pdjr-beatrice/beatrice-hood/kicad/beatrice-hood.dxf

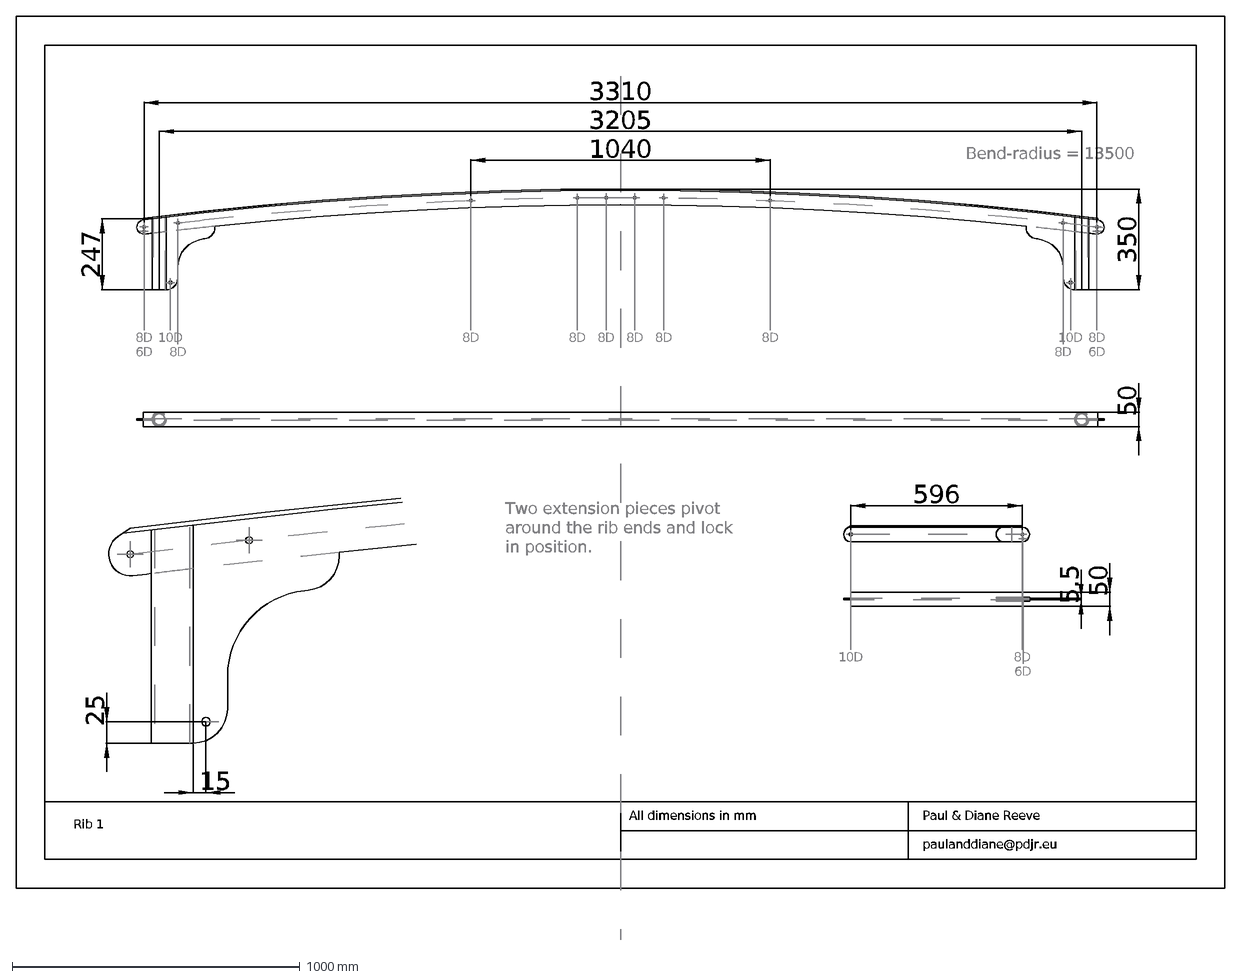
[picture p1: CAD file, 2021-06-12]
kicad/beatrice-hood.dxf
All dimensions in mm
Paul & Diane Reeve
paulanddiane@pdjr.eu
Bend-radius = 13500
25
15
8D
10D
247
6D
1040
3205
3310
350
50
596
Two extension pieces pivot around the rib ends and lock in position.
5.5
Rib 1
