pdjr-beatrice/beatrice-hood/pub/rib-1.pdf

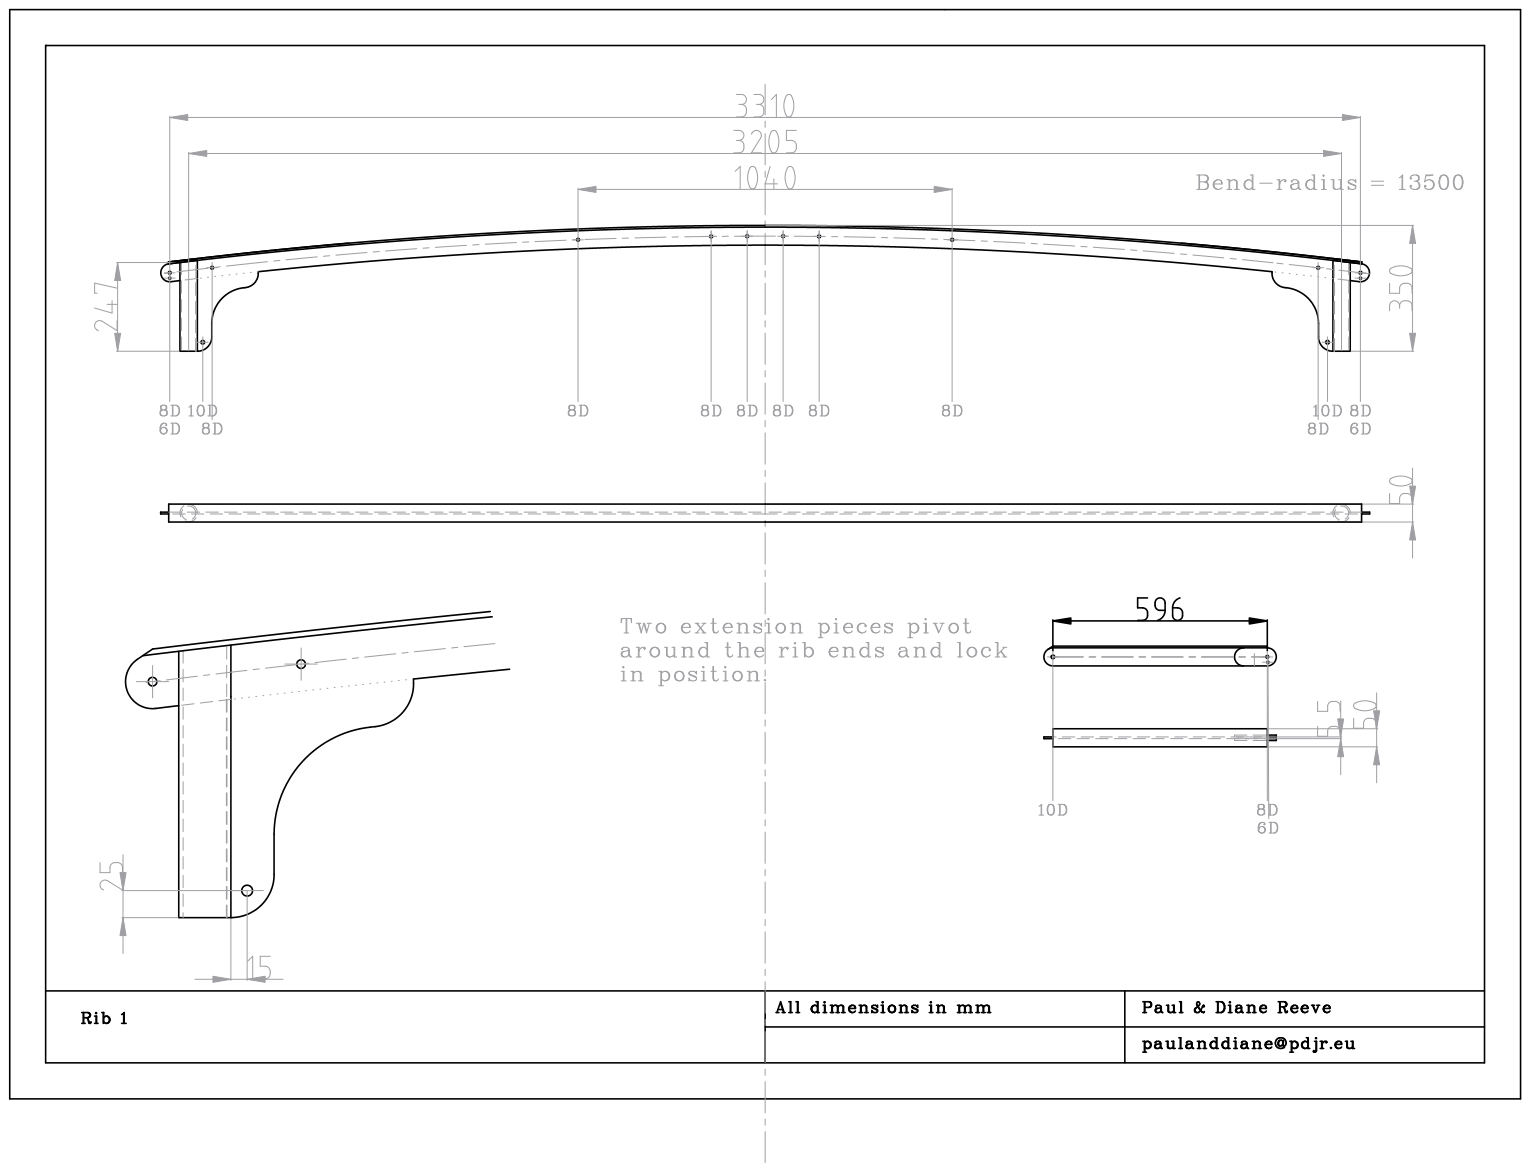
[picture p2: page 1]
