pdjr-beatrice/beatrice-hood/pub/plan.pdf

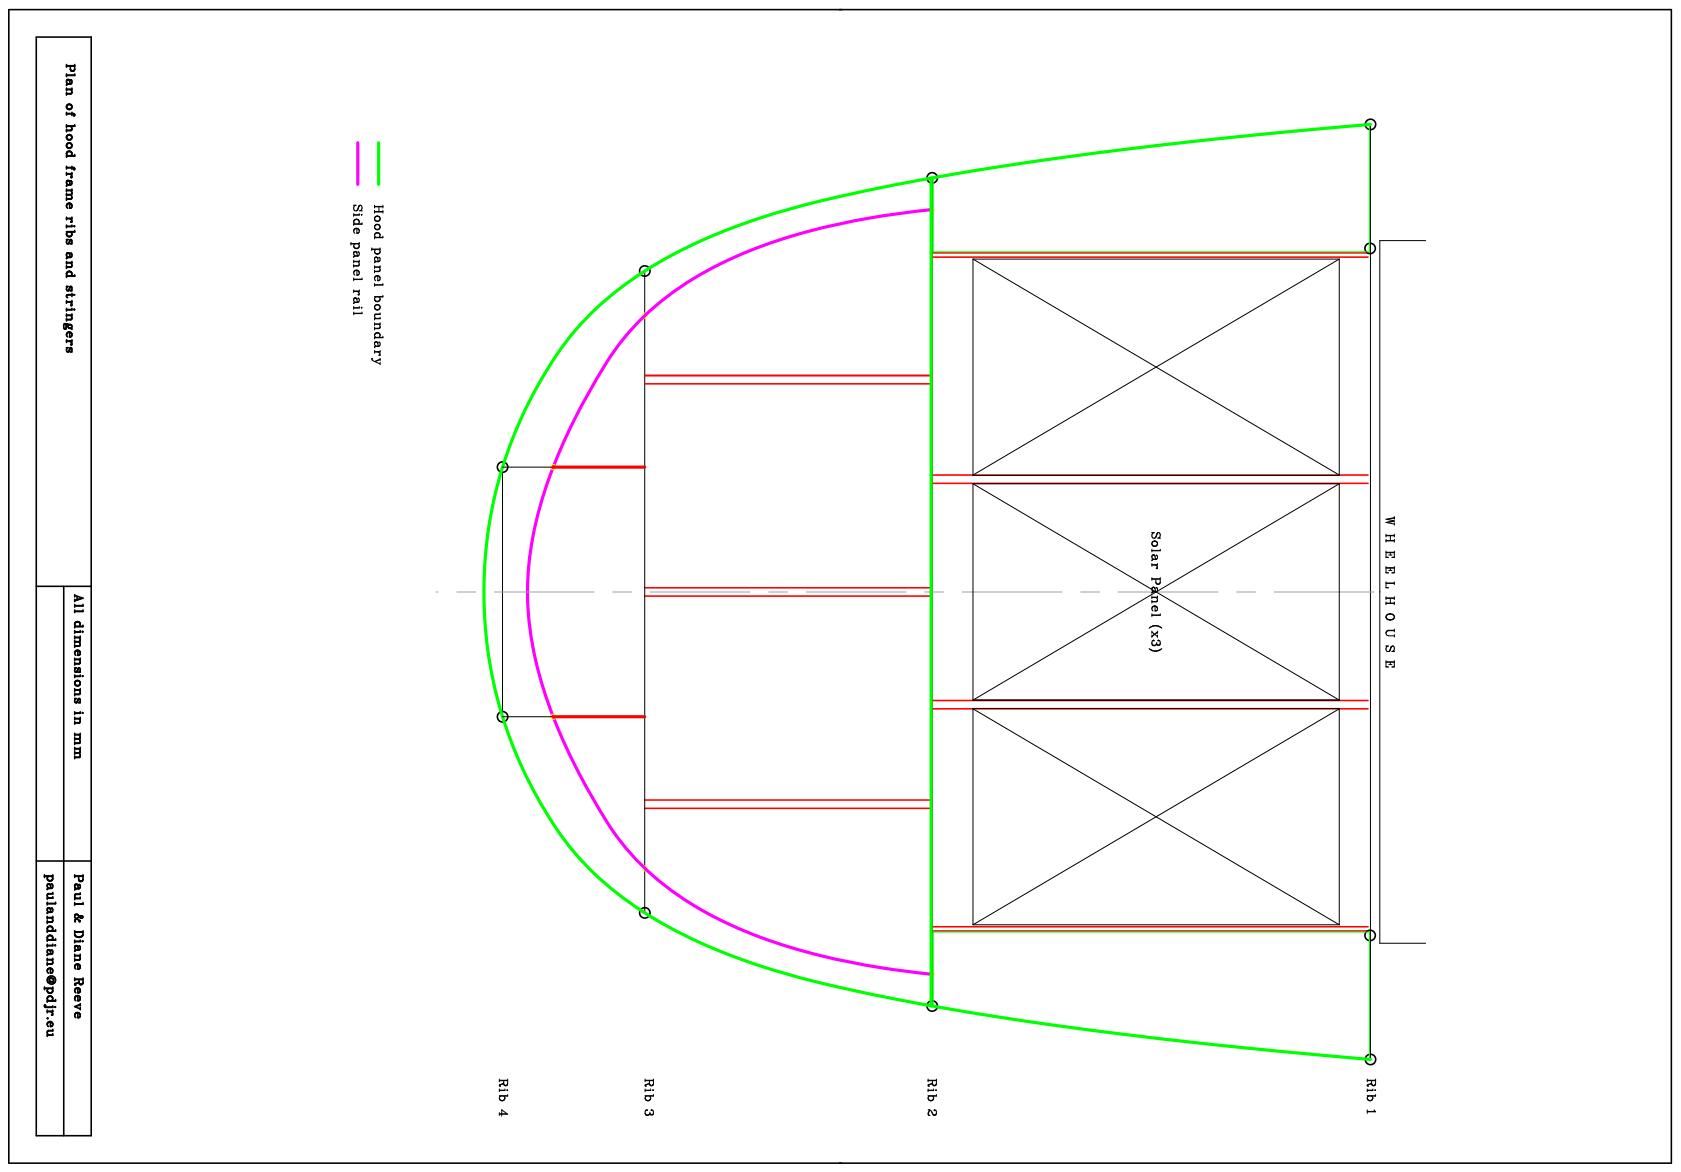
[picture p3: page 1]
