pdjr-beatrice/beatrice-hood/pub/rib-2.pdf

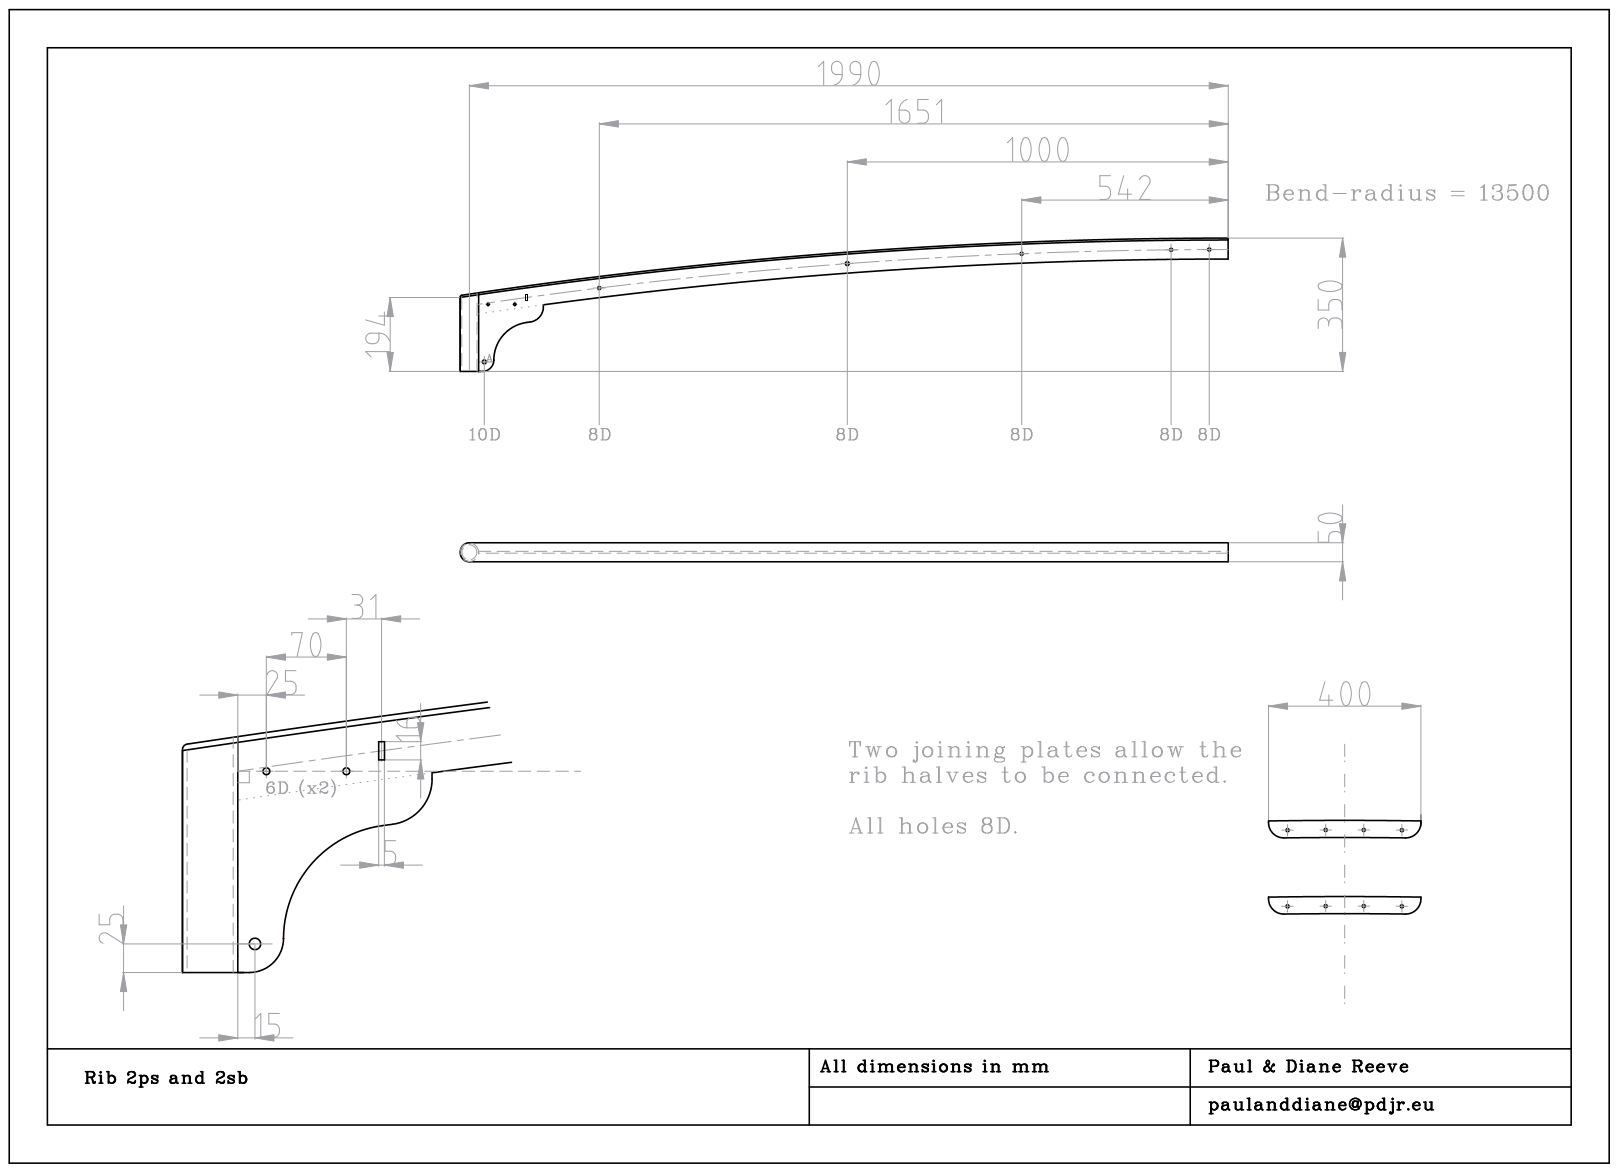
[picture p4: page 1]
