pdjr-beatrice/beatrice-hood/pub/rib-3.pdf

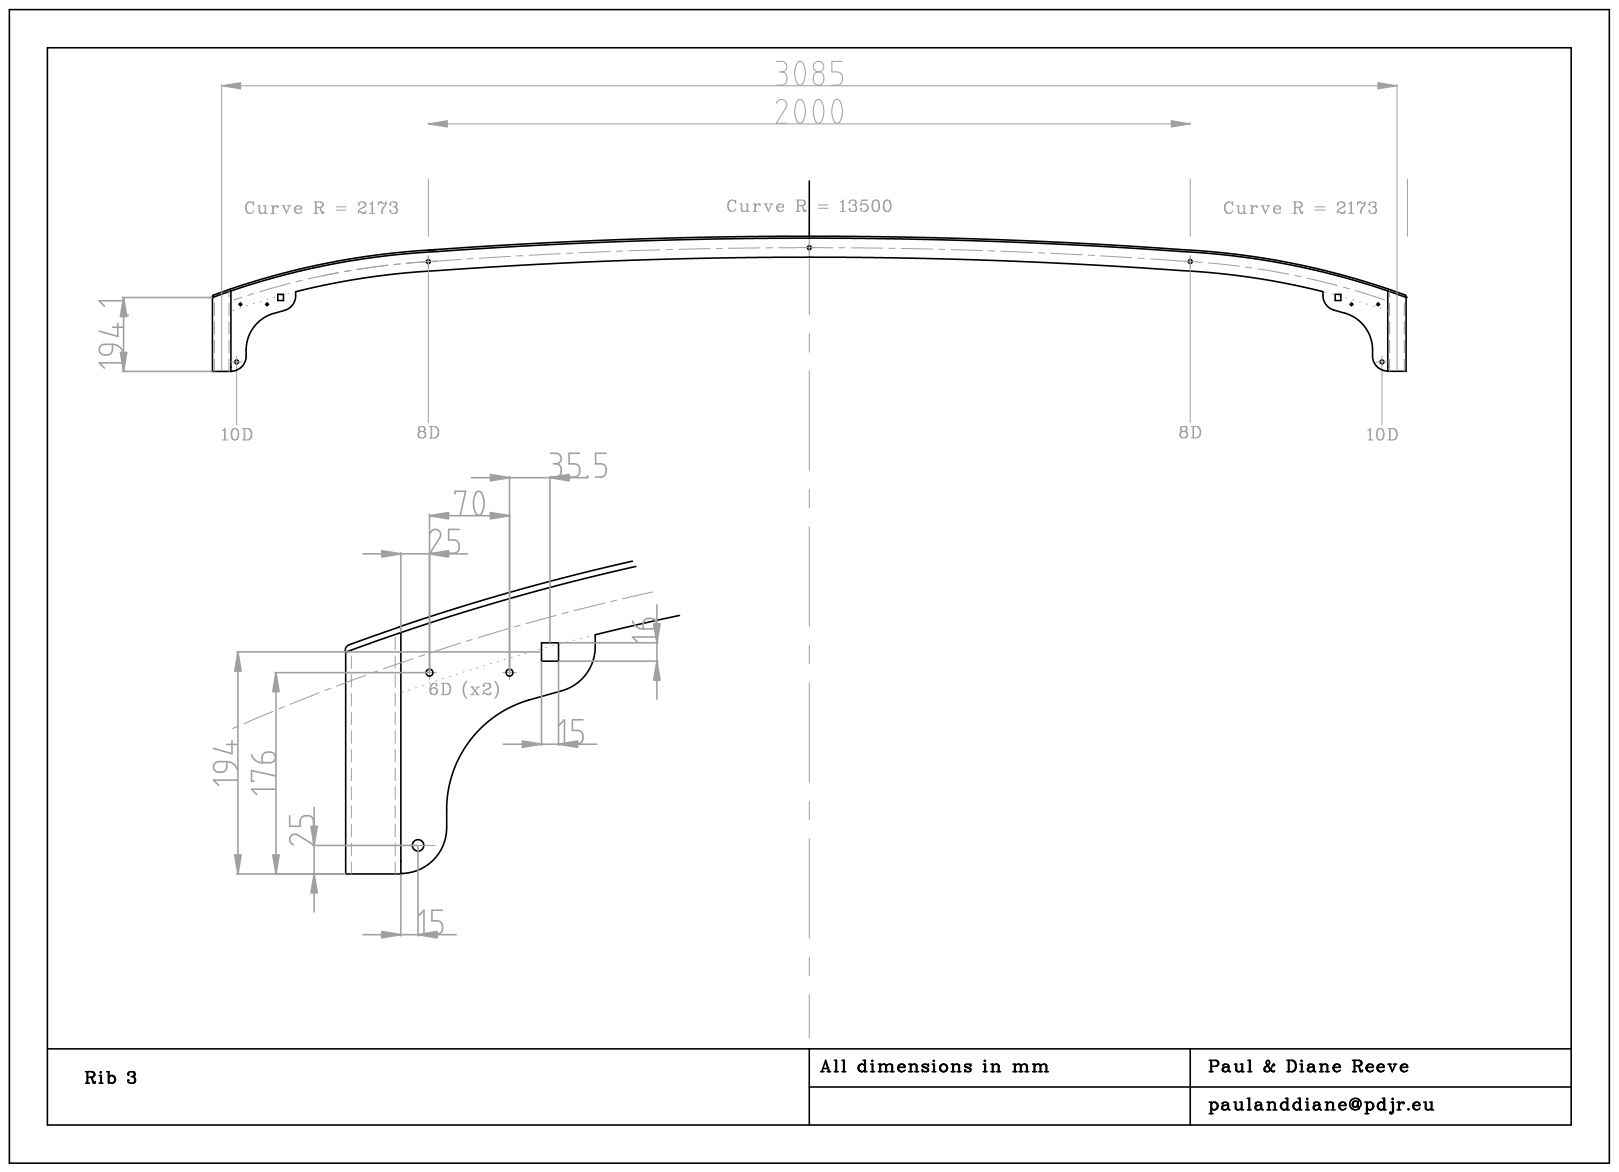
[picture p5: page 1]
