pdjr-beatrice/beatrice-hood/pub/rib-4.pdf

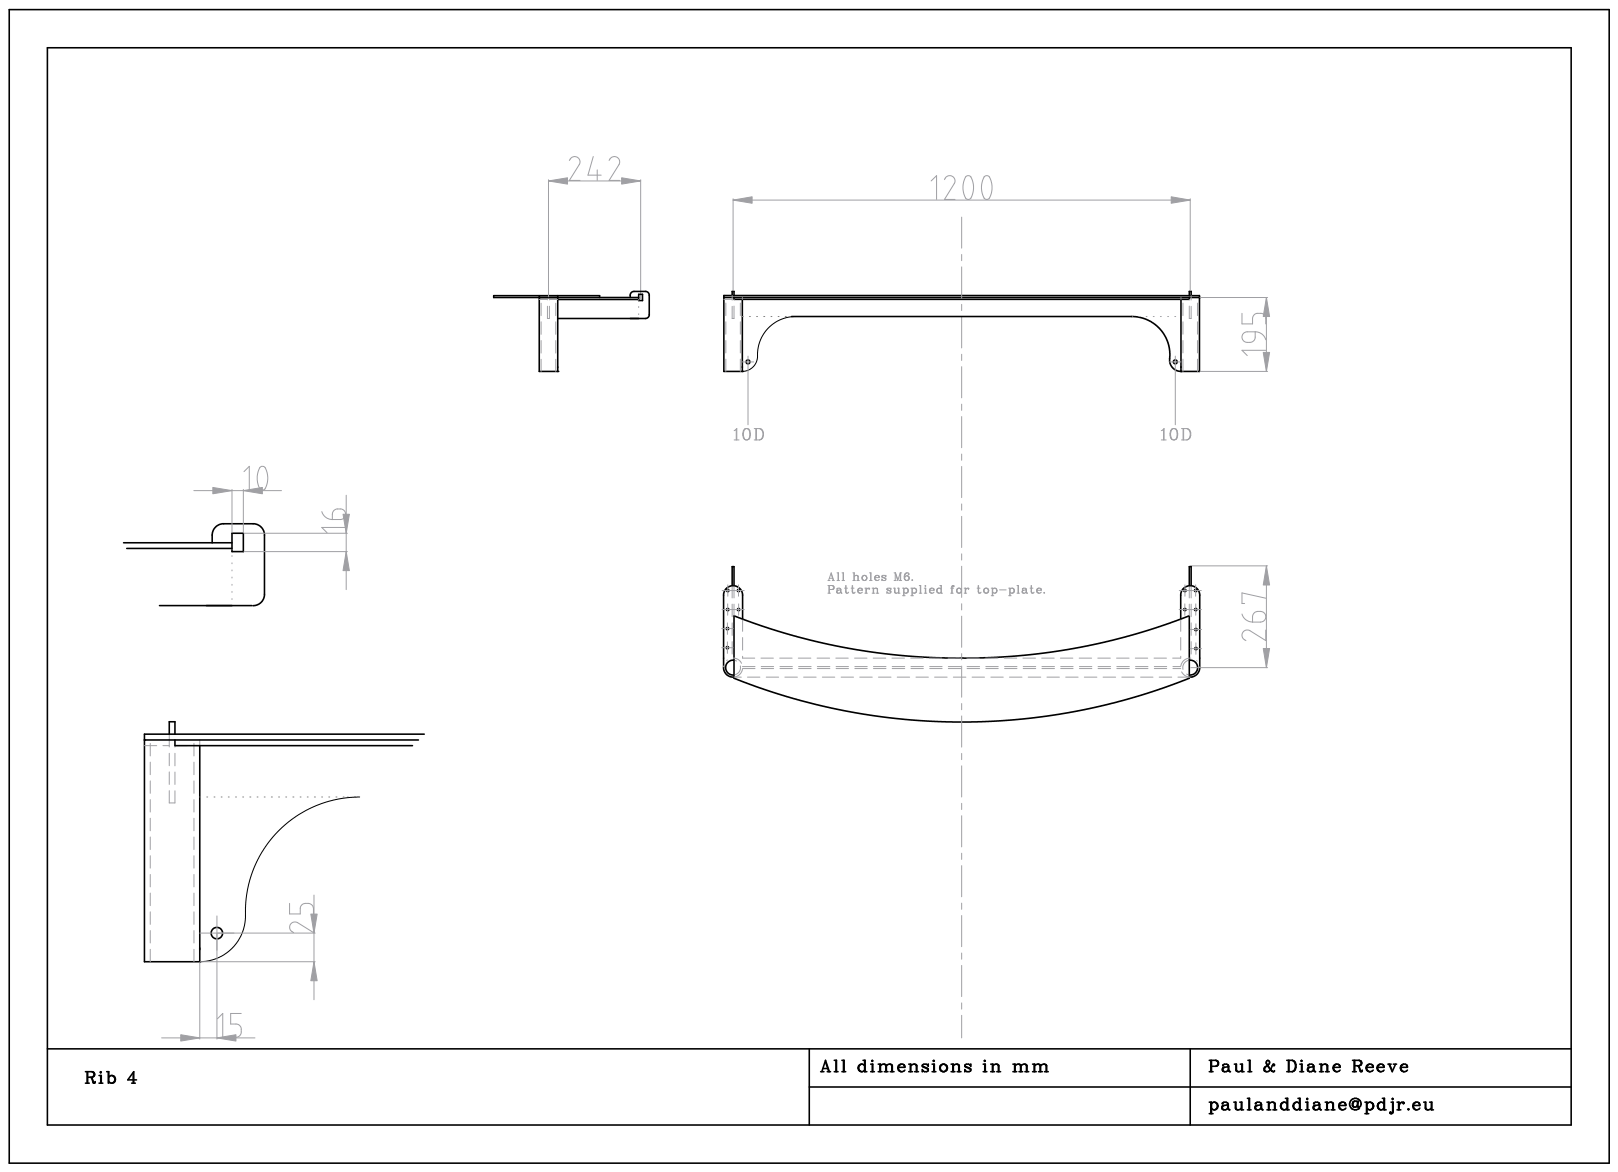
[picture p6: page 1]
