pdjr-beatrice/beatrice-hood/(commit log)

2021-06-06 First upload
    [beatrice-hood.dxf]
2021-06-06 Add hull drawing
    [beatrice-hood.dxf]
2021-06-08 Update ship
    [beatrice-hood.dxf]
2021-06-12 Add drop ends to Rib 1
    [beatrice-hood.dxf]
